Nemo-snil/Robot-Oleg/kicad/Robot.kicad_pcb

## KiCad design kicad/Robot.kicad_pcb (2025-02-16)

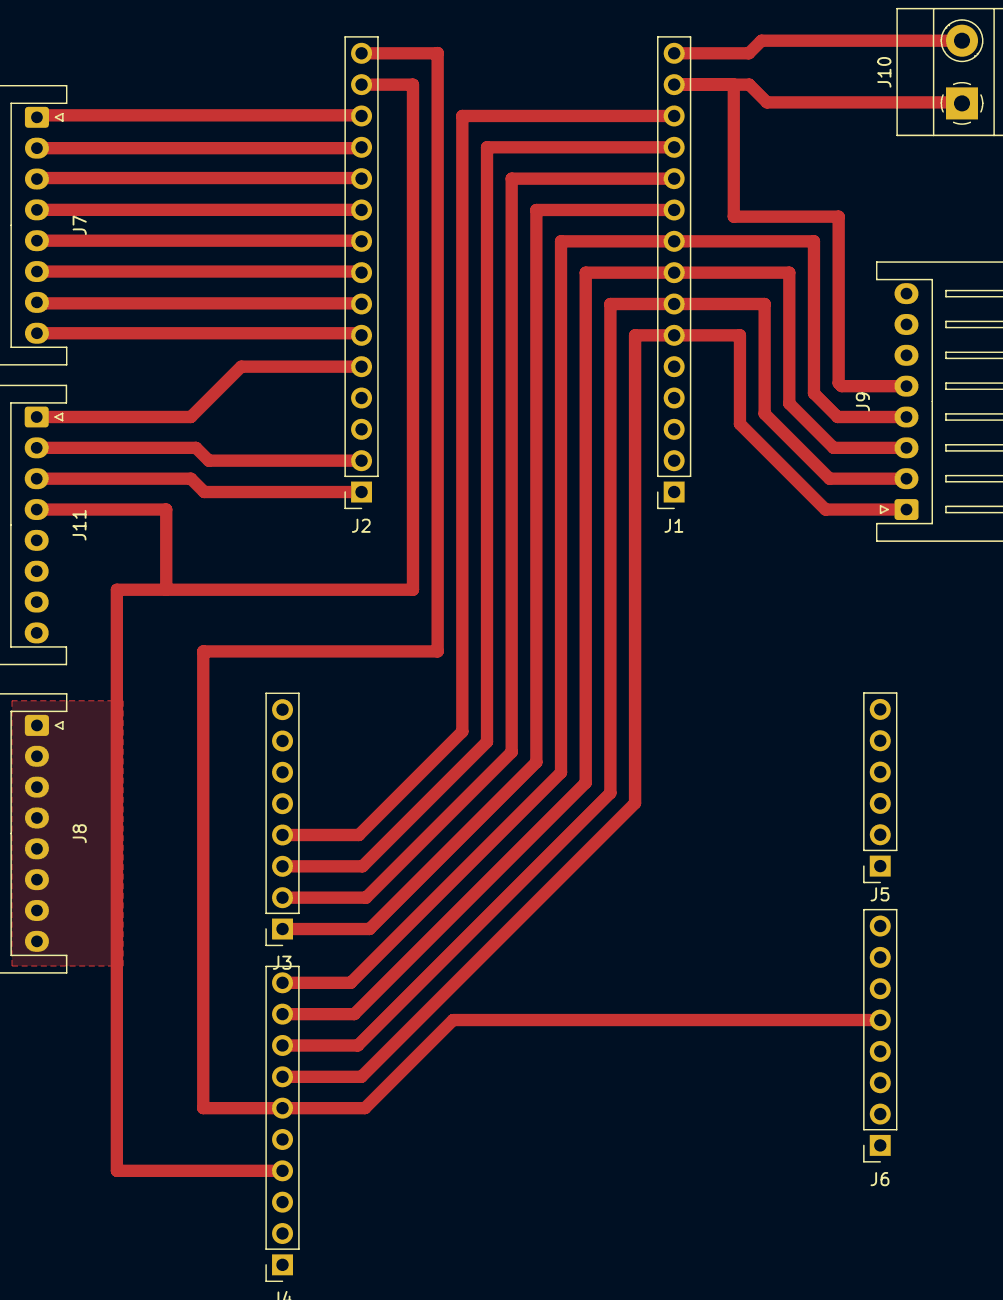
[picture p24: board Robot.kicad_pcb from above]

Board: 2 copper layers, 11 parts (0 on the bottom side), 22 nets.

Parts:
J1: ESP32 1; PinSocket_1x15_P2.54mm_Vertical
J2: ESP32 2; PinSocket_1x15_P2.54mm_Vertical
J3: Conn_01x08_Socket; PinSocket_1x08_P2.54mm_Vertical
J4: DIGITAL PWM(~); PinSocket_1x10_P2.54mm_Vertical
J5: ANALOG IN; PinSocket_1x06_P2.54mm_Vertical
J6: POWER; PinSocket_1x08_P2.54mm_Vertical
J7: Limit switch; JST_XH_S8B-XH-A_1x08_P2.50mm_Horizontal
J8: Limit switch GND; JST_XH_S8B-XH-A_1x08_P2.50mm_Horizontal
J9: BTS7960; JST_XH_S8B-XH-A_1x08_P2.50mm_Horizontal
J10: Power; TerminalBlock_Phoenix_MKDS-1,5-2-5.08_1x02_P5.08mm_Horizont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
J11: I2C; JST_XH_S8B-XH-A_1x08_P2.50mm_Horizontal

Connections:
+3.3V: J2.15, J4.6, J6.5
+12V: J1.15, J10.2
D2: J2.12, J7.2
D4: J2.11, J7.3
D5: J2.8, J7.6
D12: J1.12, J3.3
D13: J1.13, J3.4
D14: J1.11, J3.2
D15: J2.13, J7.1
D18: J2.7, J7.7
D19: J2.6, J7.8
D23: J2.1, J11.3
D25: J1.8, J4.9, J9.3
D26: J1.9, J4.10, J9.4
D27: J1.10, J3.1
D32: J1.6, J4.7, J9.1
D33: J1.7, J4.8, J9.2
GND: J1.14, J2.14, J4.4, J8.1, J8.2, J8.3, J8.4, J8.5, J8.6, J8.7, J8.8, J9.5, J10.1, J11.4
RX2: J2.10, J7.4
SCL: J2.2, J11.2
SDA: J2.5, J11.1
TX2: J2.9, J7.5
