Nemo-snil/Robot-Oleg/(commit log)

2025-02-16 Уменьшена скорость подъема и опускание механизма
2025-02-17 Изменен порт
2025-02-17 Изменения имени папки
2025-02-17 Сервис не ожидает окончания поднятия механизма
2025-02-17 Сервис не ожидает сброса энкодеров
2025-02-17 Изменен baud rate
2025-02-17 Увелиен приоритет сервиса сброса энкодеров
2025-02-17 Уменьшение скорости при управлении джойстиком
2025-02-17 Смещение камеры
2025-02-17 Увеличение стэка
2025-02-17 Устранена утечка памяти на esp32
2025-02-17 Фикс езды по аруко метке
2025-02-17 Новая карта
2025-02-17 Изменена презентация
